brianwalczak/palmvein-ir/bom.csv

Reference | Qty | Manufacturer Part | Description | Manufacturer | LCSC
C1 | 1 | CL21B105KBFNNNE | 1uF 50V X7R ±10% 0805 Multilayer Ceramic Capacitors MLCC - SMD/SMT ROHS | Samsung Electro-Mechanics | C28323
C2 | 1 | CL05B104KB54PNC | 100nF 50V X7R ±10% 0402 Multilayer Ceramic Capacitors MLCC - SMD/SMT ROHS | Samsung Electro-Mechanics | C307331
C3 | 1 | 0603B222K500NT | 2.2nF 50V X7R ±10% 0603 Multilayer Ceramic Capacitors MLCC - SMD/SMT ROHS | FH (Guangdong Fenghua Advanced Tech) | C1604
C4 | 1 | RVT1H331M1010 330UF 50V | -55℃~+105℃ 10.2mm 10mm 2800hrs@105℃ 330uF 50V ±20% SMD,D10xL10.2mm Aluminum Electrolytic Capacitors - SMD ROHS | DMBJ | C2687701
C5,C6,C8 | 3 | CS3225X7R106K500NRL | 10uF 50V X7R 1210 Multilayer Ceramic Capacitors MLCC - SMD/SMT ROHS | Samwha Capacitor | C2918502
C7 | 1 | HGC1210R5107M160NSVK | 100uF 16V X5R ±20% 1210 Multilayer Ceramic Capacitors MLCC - SMD/SMT ROHS | Chinocera | C7432790
C9 | 1 | CL31B225KBHNNNE | 2.2uF 50V X7R ±10% 1206 Multilayer Ceramic Capacitors MLCC - SMD/SMT ROHS | Samsung Electro-Mechanics | C50254
C10,C13,C14 | 3 | CL05B104KO5NNNC | 100nF 16V X7R ±10% 0402 Multilayer Ceramic Capacitors MLCC - SMD/SMT ROHS | Samsung Electro-Mechanics | C1525
C11 | 1 | TAJA226K010RNJ | -55℃~+125℃ 10V 22uF 3Ω@100kHz ±10% CASE-A-3216-18(mm) Tantalum Capacitors ROHS | -- | C11366
C12 | 1 | CC0805MKX7R7BB106 | 10uF 16V X7R ±20% 0805 Multilayer Ceramic Capacitors MLCC - SMD/SMT ROHS | YAGEO | C1952587
C15 | 1 | CL21B475KOFNNNE | 16V 4.7uF X7R ±10% 0805 Multilayer Ceramic Capacitors MLCC - SMD/SMT ROHS | Samsung Electro-Mechanics | C107365
D1 | 1 | TDS2211P.C(ES) | -40℃~+125℃ 1 1.967kW@8/20us 115pF 22V 25.6V 28.1V 500pA 70A@8/20us IEC 61000-4-2 DFN1616-6L ESD and Surge Protection (TVS/ESD) ROHS | ElecSuper | C49108767
D2,D11 | 2 | SS34 | -55℃~+125℃ 3A 40V 500uA@40V 550mV@3A Independent SMA(DO-214AC) Schottky Diodes ROHS | MDD(Microdiode Semiconductor) | C8678
D3,D4,D5,D6,D7,D8,D9,D10,D12,D13,D14,D15,D16,D17,D18,D19 | 16 | SFH 4718A | -40℃~+125℃ 1.75V 400mW/sr@IF=1A 860nm SMD-3P Infrared LED Emitters ROHS | OSRAM Opto Semicon | C2900417
J1 | 1 | TYPE-C-31-M-12 | -30℃~+80℃ 1 10,000 cycles 16P 20V 5A 7.35mm Female Surface Mount, Right Angle Type-C SMD USB Connectors ROHS | Korean Hroparts Elec | C165948
J2 | 1 | S6P-VH(LF)(SN)(P) | -25℃~+85℃ 1 10A 13.9mm 1x6P 23.7mm 250V 3.96mm 6 6P Brass PA66 Right Angle Tin UL94V-0 VH White 弯插,P=3.96mm Wire To Board Connector ROHS | JST | C495698
J3 | 1 | PZ2.54-1x4PWZ-L13.8-A | -40℃~+105℃ 1 1x4P 2.54mm 2.54mm 2.5mm 250V 3A 3mm 4P 6mm Black Brass Gold Pin Header Right Angle 弯插,P=2.54mm Pin Headers ROHS | SHOU HAN | C54907647
L1,L2 | 2 | NRSE8040-470M | 1.5A 1.75A 158mΩ 47uH Magnetic Shielded Inductor ±20% SMD,8x8mm Power Inductors ROHS | KOHERelec | C2903105
L3 | 1 | PNLS8040-2R2M 2.2UH | 12mΩ 2.2uH 8A 8A Magnetic Shielded Inductor ±20% SMD,8x8mm Power Inductors ROHS | DMBJ | C2849550
R1 | 1 | 0603WAF1203T5E | -55℃~+155℃ 100mW 120kΩ 75V Thick Film Resistor ±1% ±100ppm/℃ 0603 Chip Resistor - Surface Mount ROHS | UNI-ROYAL(Uniroyal Elec) | C25808
R2,R10 | 2 | 0603WAF1003T5E | -55℃~+155℃ 100kΩ 100mW 75V Thick Film Resistor ±1% ±100ppm/℃ 0603 Chip Resistor - Surface Mount ROHS | UNI-ROYAL(Uniroyal Elec) | C25803
R3 | 1 | 0603WAF2701T5E | -55℃~+155℃ 100mW 2.7kΩ 75V Thick Film Resistor ±1% ±100ppm/℃ 0603 Chip Resistor - Surface Mount ROHS | UNI-ROYAL(Uniroyal Elec) | C13167
R4 | 1 | 0603WAF6201T5E | -55℃~+155℃ 100mW 6.2kΩ 75V Thick Film Resistor ±1% ±100ppm/℃ 0603 Chip Resistor - Surface Mount ROHS | UNI-ROYAL(Uniroyal Elec) | C4260
R5 | 1 | 0603WAF4301T5E | -55℃~+155℃ 100mW 4.3kΩ 75V Thick Film Resistor ±1% ±100ppm/℃ 0603 Chip Resistor - Surface Mount ROHS | UNI-ROYAL(Uniroyal Elec) | C23159
R6,R7 | 2 | RLH12FTCR110 | 110mΩ 1W Current Sense Resistor SMD ±1% ±100ppm/℃ 1206 Current Sense Resistors / Shunt Resistors ROHS | TA-I Tech | C22464898
R8 | 1 | 0603WAF2203T5E | -55℃~+155℃ 100mW 220kΩ 75V Thick Film Resistor ±1% ±100ppm/℃ 0603 Chip Resistor - Surface Mount ROHS | UNI-ROYAL(Uniroyal Elec) | C22961
R9 | 1 | 0603WAF3002T5E | -55℃~+155℃ 100mW 30kΩ 75V Thick Film Resistor ±1% ±100ppm/℃ 0603 Chip Resistor - Surface Mount ROHS | UNI-ROYAL(Uniroyal Elec) | C22984
R11,R14 | 2 | 0603WAF3601T5E | -55℃~+155℃ 100mW 3.6kΩ 75V Thick Film Resistor ±1% ±100ppm/℃ 0603 Chip Resistor - Surface Mount ROHS | UNI-ROYAL(Uniroyal Elec) | C22980
R12,R13 | 2 | 0603WAF1002T5E | -55℃~+155℃ 100mW 10kΩ 75V Thick Film Resistor ±1% ±100ppm/℃ 0603 Chip Resistor - Surface Mount ROHS | UNI-ROYAL(Uniroyal Elec) | C25804
U1 | 1 | CH224A | -40℃~+105℃ 140W 1C 4V~30V 5V、9V、12V、15V、20V、28V PD 3.2、BC 1.2、AVS、PPS、SPR Power Receiver Controller ESSOP-10 USB PD ROHS | WCH(Jiangsu Qin Heng) | C42459160
U2 | 1 | MX25947ES | -40℃~+125℃ 1 1.4mm 28mΩ 3.9mm 4.5V~24V 4.9mm Integrated FET Surface Mount ESOP8 Surge Protection Devices (SPDs) ROHS | Wuxi Maxinmicro | C5875698
U3,U4 | 2 | AL8861Y-13 | -40℃~+85℃ 1 1.5A 1MHz 4.5V~40V 5% Analog、PWM Buck Built-in DC-DC Over-Temperature Protection (OTP)、Short-Circuit Protection SOT-89-5 LED Drivers ROHS | Diodes Incorporated | C507867
U5 | 1 | SY8366HQQC | -40℃~+150℃ 1 100uA 4V~28V 5V 6A 800kHz Buck Buck Built-in Fixed Yes QFN-12-EP(3x3) DC-DC Converters ROHS | Silergy Corp | C178253
U6 | 1 | AMS1117-3.3 | -40℃~+125℃ 0.003%Vout 1 1.3V@(1A) 12V 1A 3.3V 5mA 60dB@(120Hz) Fixed Over Current Protection Positive SOT-223 Voltage Regulators - Linear, Low Drop Out (LDO) Regulators ROHS | UMW(Youtai Semiconductor Co., Ltd.) | C347222
U7 | 1 | CH32V003A4M6 | SOP-16 Microcontrollers (MCU/MPU/SOC) ROHS | WCH(Jiangsu Qin Heng) | C5346357
U8 | 1 | VL53L4CDV0DH/1 | -30℃~+85℃ 0cm~130cm 1mm 2.4mm 2.6V~3.5V 24mA 4.4mm I2C Temperature compensation Yes SMD-12P Position Sensors ROHS | STMicroelectronics | C3178291
