brianwalczak/palmvein-ir/Palm Vein Illuminator.kicad_pcb

## KiCad design Palm Vein Illuminator.kicad_pcb (2026-10-23)

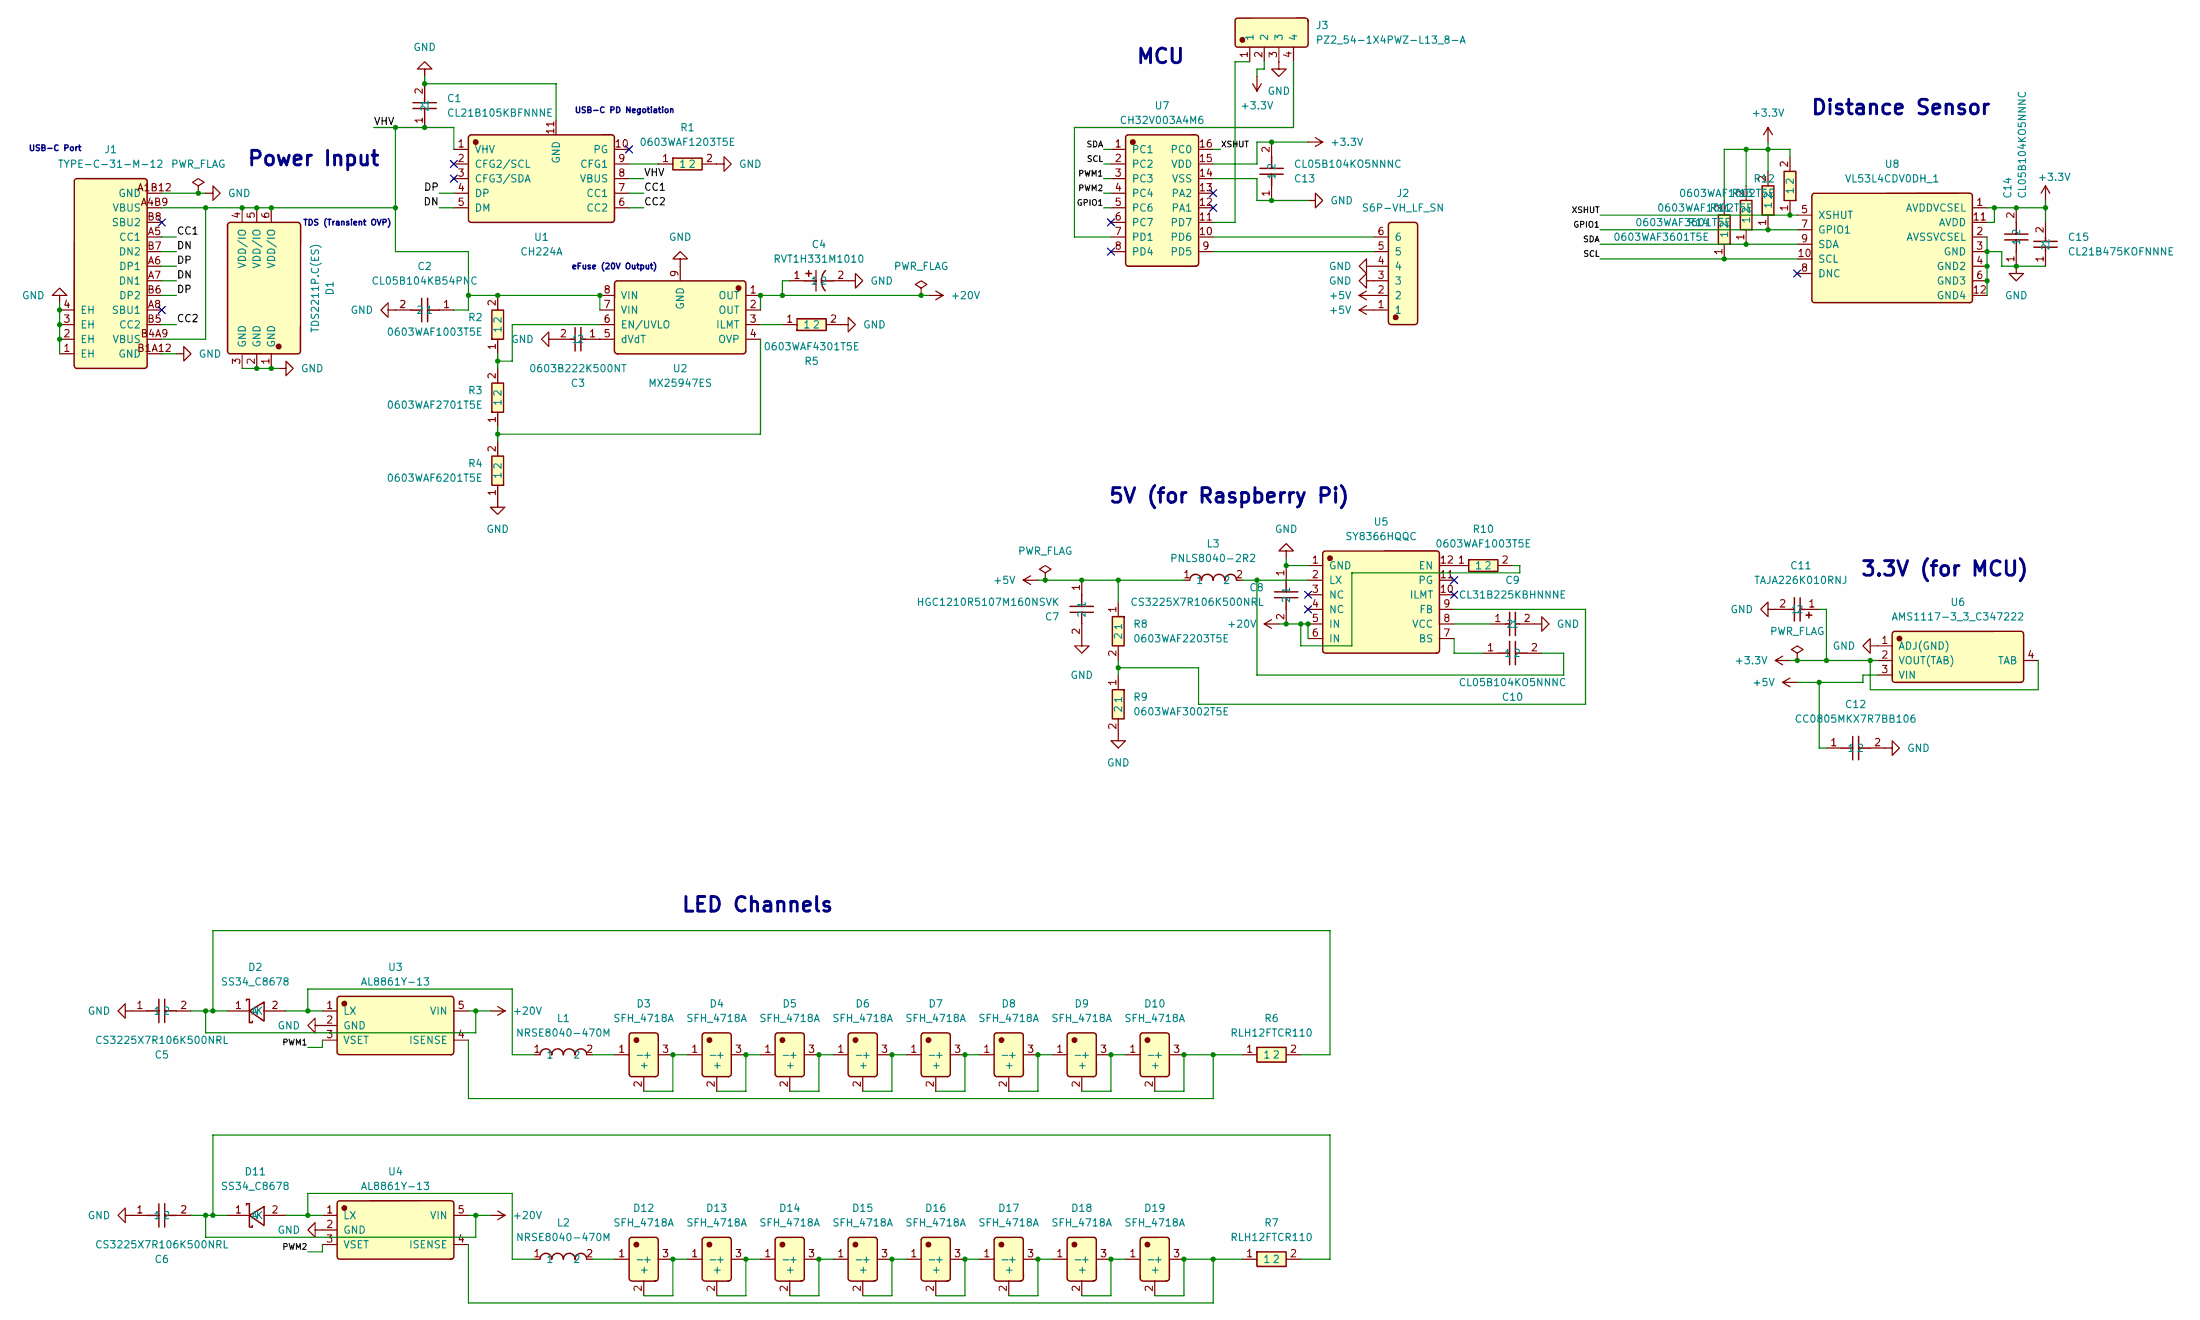
[picture p1: schematic Palm Vein Illuminator.kicad_sch]

Parts:
C1: CL21B105KBFNNNE; Manufacturer Part CL21B105KBFNNNE; LCSC C28323
C2: CL05B104KB54PNC; Manufacturer Part CL05B104KB54PNC; LCSC C307331
C3: 0603B222K500NT; Manufacturer Part 0603B222K500NT; LCSC C1604
C4: RVT1H331M1010; Manufacturer Part RVT1H331M1010 330UF 50V; LCSC C2687701
C5, C6, C8: CS3225X7R106K500NRL; Manufacturer Part CS3225X7R106K500NRL; LCSC C2918502
C7: HGC1210R5107M160NSVK; Manufacturer Part HGC1210R5107M160NSVK; LCSC C7432790
C9: CL31B225KBHNNNE; Manufacturer Part CL31B225KBHNNNE; LCSC C50254
C10, C13, C14: CL05B104KO5NNNC; Manufacturer Part CL05B104KO5NNNC; LCSC C1525
C11: TAJA226K010RNJ; Manufacturer Part TAJA226K010RNJ; LCSC C11366
C12: CC0805MKX7R7BB106; Manufacturer Part CC0805MKX7R7BB106; LCSC C1952587
C15: CL21B475KOFNNNE; Manufacturer Part CL21B475KOFNNNE; LCSC C107365
D1: TDS2211P.C(ES); Manufacturer Part TDS2211P.C(ES); LCSC C49108767
D2, D11: SS34_C8678; Manufacturer Part SS34; LCSC C8678
D3, D4, D5, D6, D7, D8, D9, D10, D12, D13, D14, D15, D16, D17, D18, D19: SFH_4718A; Manufacturer Part SFH 4718A; LCSC C2900417
J1: TYPE-C-31-M-12; Manufacturer Part TYPE-C-31-M-12; LCSC C165948
J2: S6P-VH_LF_SN; Manufacturer Part S6P-VH(LF)(SN)(P); LCSC C495698
J3: PZ2_54-1X4PWZ-L13_8-A; Manufacturer Part PZ2.54-1x4PWZ-L13.8-A; LCSC C54907647
L1, L2: NRSE8040-470M; Manufacturer Part NRSE8040-470M; LCSC C2903105
L3: PNLS8040-2R2; Manufacturer Part PNLS8040-2R2M 2.2UH; LCSC C2849550
R1: 0603WAF1203T5E; Manufacturer Part 0603WAF1203T5E; LCSC C25808
R2, R10: 0603WAF1003T5E; Manufacturer Part 0603WAF1003T5E; LCSC C25803
R3: 0603WAF2701T5E; Manufacturer Part 0603WAF2701T5E; LCSC C13167
R4: 0603WAF6201T5E; Manufacturer Part 0603WAF6201T5E; LCSC C4260
R5: 0603WAF4301T5E; Manufacturer Part 0603WAF4301T5E; LCSC C23159
R6, R7: RLH12FTCR110; Manufacturer Part RLH12FTCR110; LCSC C22464898
R8: 0603WAF2203T5E; Manufacturer Part 0603WAF2203T5E; LCSC C22961
R9: 0603WAF3002T5E; Manufacturer Part 0603WAF3002T5E; LCSC C22984
R11, R14: 0603WAF3601T5E; Manufacturer Part 0603WAF3601T5E; LCSC C22980
R12, R13: 0603WAF1002T5E; Manufacturer Part 0603WAF1002T5E; LCSC C25804
U1: CH224A; Manufacturer Part CH224A; LCSC C42459160
U2: MX25947ES; Manufacturer Part MX25947ES; LCSC C5875698
U3, U4: AL8861Y-13; Manufacturer Part AL8861Y-13; LCSC C507867
U5: SY8366HQQC; Manufacturer Part SY8366HQQC; LCSC C178253
U6: AMS1117-3_3_C347222; Manufacturer Part AMS1117-3.3; LCSC C347222
U7: CH32V003A4M6; Manufacturer Part CH32V003A4M6; LCSC C5346357
U8: VL53L4CDV0DH_1; Manufacturer Part VL53L4CDV0DH/1; LCSC C3178291

Connections:
+3.3V: C11.1, C13.2, C14.2, C15.2, J3.2, R11.2, R12.2, R13.2, R14.2, U6.2 (VOUT(TAB)), U6.4 (TAB), U7.15 (VDD), U8.1 (AVDDVCSEL), U8.11 (AVDD)
+5V: C7.1, C12.1, J2.1, J2.2, L3.1, R8.1, U6.3 (VIN)
+20V: C4.1, C5.2, C6.2, C8.2, D2.1 (K), D11.1 (K), R6.2, R7.2, R10.2, U2.1 (OUT), U2.2 (OUT), U3.5 (VIN), U4.5 (VIN), U5.5 (IN), U5.6 (IN)
/CC1: J1.A5 (CC1), U1.7 (CC1)
/CC2: J1.B5 (CC2), U1.6 (CC2)
/DN: J1.A7 (DN1), J1.B7 (DN2), U1.5 (DM)
/DP: J1.A6 (DP1), J1.B6 (DP2), U1.4 (DP)
/GPIO1: R13.1, U7.5 (PC6), U8.7 (GPIO1)
/PWM1: U3.3 (VSET), U7.3 (PC3)
/PWM2: U4.3 (VSET), U7.4 (PC4)
/SCL: R14.1, U7.2 (PC2), U8.10 (SCL)
/SDA: R11.1, U7.1 (PC1), U8.9 (SDA)
/VHV: C1.1, C2.1, D1.4 (VDD/IO), D1.5 (VDD/IO), D1.6 (VDD/IO), J1.A4B9 (VBUS), J1.B4A9 (VBUS), R2.2, U1.1 (VHV), U1.8 (VBUS), U2.7 (VIN), U2.8 (VIN)
/XSHUT: R12.1, U7.16 (PC0), U8.5 (XSHUT)
GND: C1.2, C2.2, C3.2, C4.2, C5.1, C6.1, C7.2, C8.1, C9.2, C11.2, C12.2, C13.1, C14.1, C15.1, D1.1 (GND), D1.2 (GND), D1.3 (GND), J1.1 (EH), J1.2 (EH), J1.3 (EH), J1.4 (EH), J1.A1B12 (GND), J1.B1A12 (GND), J2.3, J2.4, J3.3, R1.2, R4.1, R5.2, R9.2, U1.11 (GND), U2.9 (GND), U3.2 (GND), U4.2 (GND), U5.1 (GND), U6.1 (ADJ(GND)), U7.14 (VSS), U8.2 (AVSSVCSEL), U8.3 (GND), U8.4 (GND2), U8.6 (GND3), U8.12 (GND4)
unnamed: D2.2 (A), L1.1, U3.1 (LX)
unnamed: D3.1 (-), L1.2
unnamed: D3.2 (+), D3.3 (+), D4.1 (-)
unnamed: D4.2 (+), D4.3 (+), D5.1 (-)
unnamed: D5.2 (+), D5.3 (+), D6.1 (-)
unnamed: D6.2 (+), D6.3 (+), D7.1 (-)
unnamed: D7.2 (+), D7.3 (+), D8.1 (-)
unnamed: D8.2 (+), D8.3 (+), D9.1 (-)
unnamed: D9.2 (+), D9.3 (+), D10.1 (-)
unnamed: D11.2 (A), L2.1, U4.1 (LX)
unnamed: D12.1 (-), L2.2
unnamed: D12.2 (+), D12.3 (+), D13.1 (-)
unnamed: D13.2 (+), D13.3 (+), D14.1 (-)
unnamed: D14.2 (+), D14.3 (+), D15.1 (-)
unnamed: D15.2 (+), D15.3 (+), D16.1 (-)
unnamed: D16.2 (+), D16.3 (+), D17.1 (-)
unnamed: D17.2 (+), D17.3 (+), D18.1 (-)
unnamed: D18.2 (+), D18.3 (+), D19.1 (-)
unnamed: R1.1, U1.9 (CFG1)
unnamed: R2.1, R3.2, U2.6 (EN/UVLO)
unnamed: R5.1, U2.3 (ILMT)
unnamed: R3.1, R4.2, U2.4 (OVP)
unnamed: C3.1, U2.5 (dVdT)
unnamed: D10.2 (+), D10.3 (+), R6.1, U3.4 (ISENSE)
unnamed: D19.2 (+), D19.3 (+), R7.1, U4.4 (ISENSE)
unnamed: C10.1, U5.7 (BS)
unnamed: R10.1, U5.12 (EN)
unnamed: R8.2, R9.1, U5.9 (FB)
unnamed: C10.2, L3.2, U5.2 (LX)
unnamed: C9.1, U5.8 (VCC)
unnamed: J3.4, U7.7 (PD1)
unnamed: J2.5, U7.9 (PD5)
unnamed: J2.6, U7.10 (PD6)
unnamed: J3.1, U7.11 (PD7)

Notes on the sheet:
eFuse (20V Output)
Distance Sensor
TDS (Transient OVP)
3.3V (for MCU)
USB-C Port
LED Channels
5V (for Raspberry Pi)
Power Input
MCU
USB-C PD Negotiation

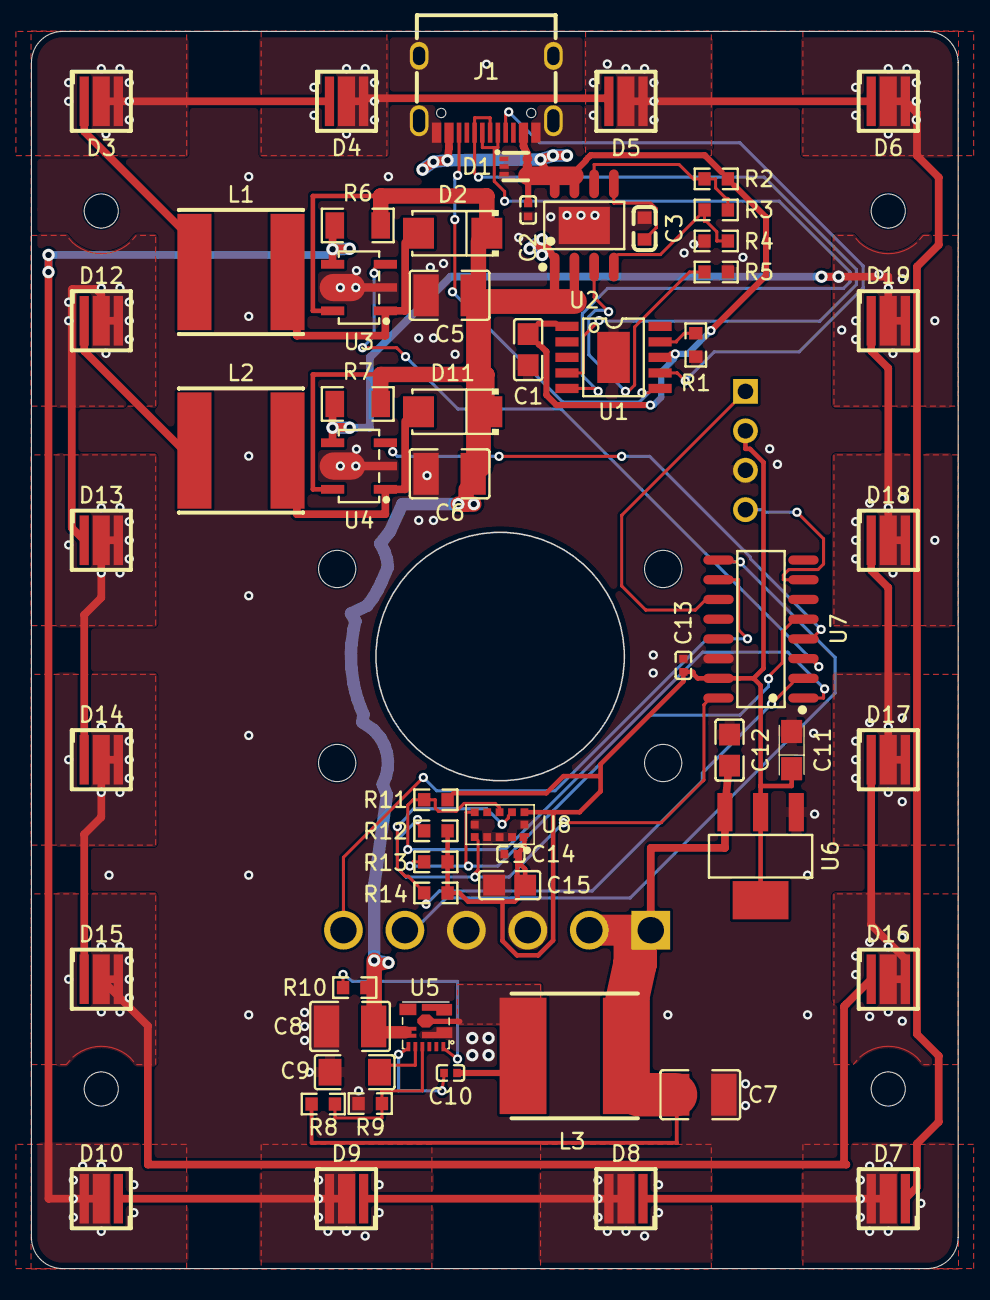
[picture p2: board Palm Vein Illuminator.kicad_pcb from above]

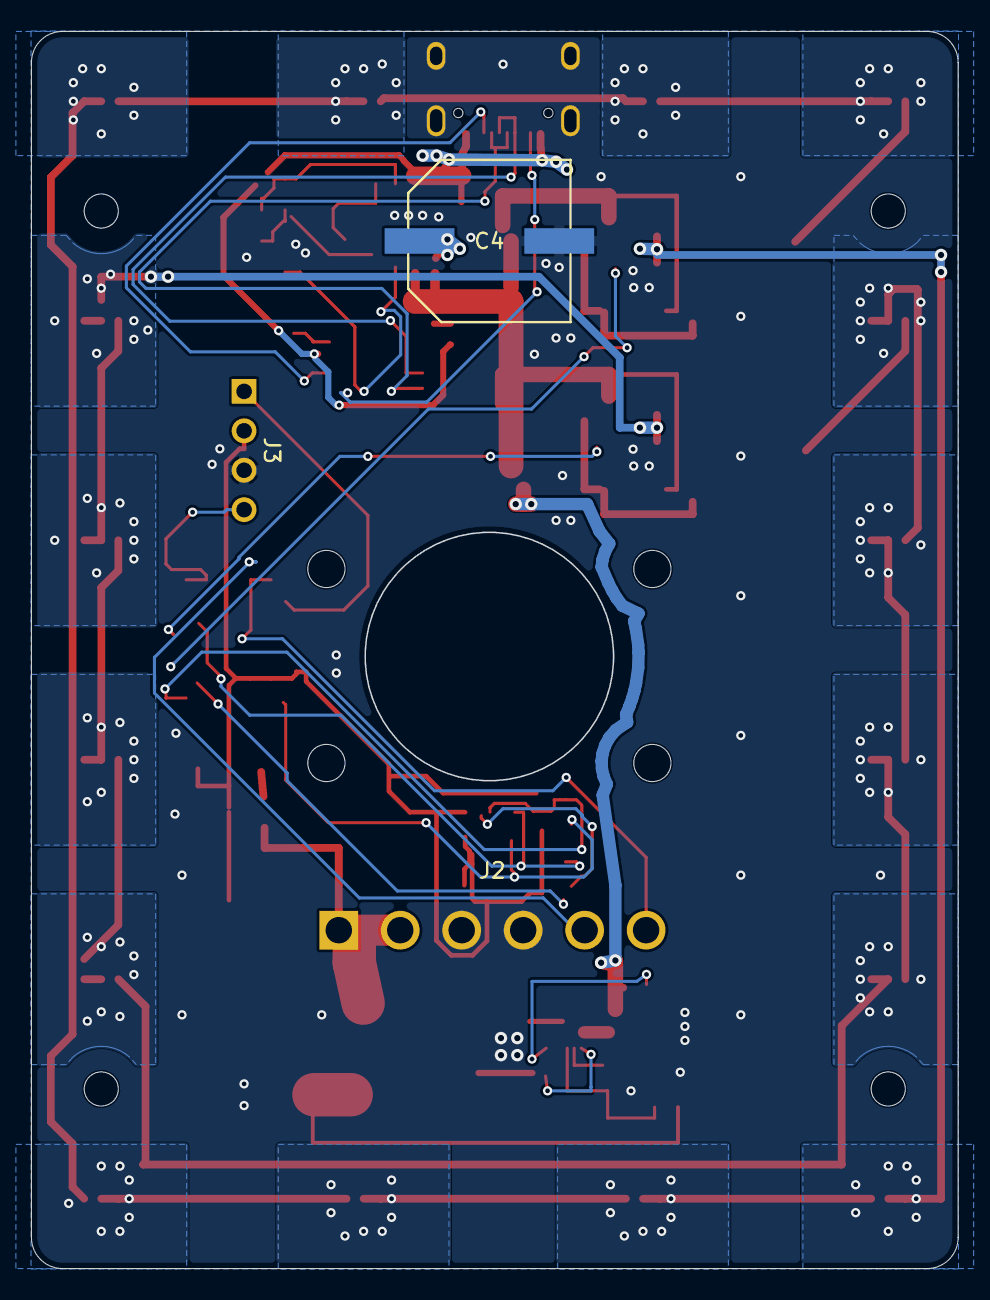
[picture p3: board Palm Vein Illuminator.kicad_pcb from below]

Board: 2 copper layers, 59.7 x 79.7 mm, 70 parts (3 on the bottom side), 49 nets.

Other parts of the board:
H1, H2, H3, H4, H5, H6, H7, H8: MountingHole_2.2mm_M2
