brianwalczak/palmvein-ir/(commit log)

2026-10-20 Add schematic, BOM, and README
    [Palm Vein Illuminator.kicad_pcb, Palm Vein Illuminator.kicad_sch, bom.csv]
2026-10-20 Add PCB component placement
    [Palm Vein Illuminator.kicad_pcb]
2026-10-20 Route PCB and add copper pours
    [Palm Vein Illuminator.kicad_pcb]
2026-10-23 Add gerber data and config
    [Palm Vein Illuminator-B_Cu.gbl, Palm Vein Illuminator-B_Mask.gbs, Palm Vein Illuminator-B_Paste.gbp, Palm Vein Illuminator-B_Silkscreen.gbo, Palm Vein Illuminator-Edge_Cuts.gm1, Palm Vein Illuminator-F_Cu.gtl, Palm Vein Illuminator-F_Mask.gts, Palm Vein Illuminator-F_Paste.gtp]
